jiwon-kang-dev/stm32-can-pedal-dashboard-ecu/README.md

# STM32 CAN Pedal–Dashboard ECU Simulator

A two-node embedded system that reads a simulated accelerator-pedal input, transmits the pedal position over CAN, controls a dashboard LED using PWM, and activates fail-safe behavior when communication is lost.

## Project Overview

This project simulates a basic automotive in-vehicle communication system using two STM32 Nucleo-F446RE boards.

The **Pedal ECU** reads an analog pedal input through ADC, converts the measured value into a pedal percentage from 0% to 100%, and transmits the result periodically over CAN.

The **Dashboard ECU** receives the pedal message, controls the onboard LED brightness through PWM, detects CAN communication timeout, and forces the LED output to zero as a fail-safe action.

When CAN communication is restored, the Dashboard ECU automatically returns to normal operation.

---

## Hardware

- STM32 Nucleo-F446RE x2
- SN65HVD230 CAN Transceiver x2
- 10kΩ Potentiometer
- LED
- 120Ω termination resistor x2
- Breadboard and jumper wires
- Logic Analyzer

---

## Development Environment

- STM32CubeIDE
- STM32CubeMX
- Tera Term
- Windows

---

## Project Highlights

- Two STM32 Nucleo-F446RE boards operating as independent ECUs
- Analog pedal input measured using a 12-bit ADC
- Pedal position converted into a percentage from 0% to 100%
- Standard CAN communication at 500 kbps
- Pedal message transmitted every 100 ms
- Dashboard LED brightness controlled using PWM
- CAN timeout detection after 1 second without a valid message
- Fail-safe LED OFF behavior and automatic recovery
- Non-blocking super-loop structure using `HAL_GetTick()`
- CAN frame and transmission period verified using a logic analyzer

---

## System Architecture

```mermaid
flowchart LR
    POT[10 kΩ Potentiometer] -->|Analog voltage| PEDAL[Pedal ECU<br/>STM32F446RE]
    PEDAL -->|ADC 0–4095| SCALE[Pedal Position<br/>0–100%]
    SCALE -->|CAN ID 0x100<br/>100 ms period| BUS[CAN Bus<br/>500 kbps]
    BUS --> DASH[Dashboard ECU<br/>STM32F446RE]
    DASH -->|Pedal % to PWM duty| LED[Dashboard LD2]
    DASH -->|No valid frame for 1 s| SAFE[Fail-safe<br/>PWM = 0]
```

### ECU Responsibilities

| ECU | Input | Processing | Output |
|---|---|---|---|
| Pedal ECU | Potentiometer through ADC | Converts the 12-bit ADC value into a pedal percentage and transmits it periodically | CAN message `0x100` |
| Dashboard ECU | CAN message `0x100` | Validates the pedal data, calculates PWM duty, and monitors communication timeout | LD2 brightness, UART logs, and fail-safe output |

---

## Implementation Status

- [x] UART debugging using register-level code and STM32 HAL
- [x] Analog pedal input measurement using ADC
- [x] Pedal percentage conversion from 0% to 100%
- [x] Dashboard LED brightness control using PWM
- [x] CAN transmission and reception between two ECUs
- [x] CAN timeout detection and fail-safe LED OFF behavior
- [x] Automatic recovery after CAN communication is restored
- [x] Non-blocking periodic processing using `HAL_GetTick()`
- [x] CAN waveform, transmission period, and frame verified using a logic analyzer
- [x] Final integrated system demo

---

## CAN Message Specification

The Pedal ECU reads the potentiometer value through ADC, converts it into a pedal position from 0% to 100%, and transmits the result to the Dashboard ECU through CAN.

| Field | Specification |
|---|---|
| CAN frame type | Standard 11-bit identifier |
| CAN ID | `0x100` |
| Bitrate | 500 kbps |
| DLC | 1 byte |
| `Data[0]` | Pedal position from `0` to `100` |
| Transmission period | 100 ms |
| CAN TX pin | PB9 |
| CAN RX pin | PB8 |
| Timeout threshold | 1000 ms |

### Payload Example

```text
Data[0] = 0x43
0x43 = 67 decimal
Pedal position = 67%
```

The Dashboard ECU receives CAN message `0x100`, checks whether the pedal value is within the valid range of 0 to 100, and converts the received value into PWM duty.

The onboard LED brightness changes according to the received pedal position.

If no valid pedal message is received for more than 1000 ms, the Dashboard ECU activates the fail-safe state and forces the PWM duty to zero.

When a valid CAN message is received again, the fail-safe state is cleared and normal PWM control resumes.

---

## Verification Results

| Test Item | Result |
|---|---|
| ADC pedal input | Potentiometer value successfully converted into a pedal position from 0% to 100% |
| CAN transmission | Pedal ECU periodically transmitted CAN message `0x100` |
| CAN reception | Dashboard ECU successfully received and validated the pedal data |
| PWM control | Dashboard LD2 brightness changed according to the received pedal position |
| Timeout detection | Communication loss detected after approximately 1000 ms |
| Fail-safe behavior | PWM duty forced to zero and Dashboard LD2 turned off |
| Communication recovery | Normal PWM control resumed after receiving a valid CAN message |
| Transmission period | Logic analyzer measurement confirmed approximately 100 ms |
| CAN frame decoding | CAN ID `0x100`, DLC `1`, and pedal payload successfully decoded |
| TXD/RXD comparison | Matching CAN frame patterns observed between transmitter TXD and receiver RXD |

---

## Demo and Evidence

### Final Integrated System Demo

The Pedal ECU reads the potentiometer input, converts it into a pedal percentage, and transmits the value to the Dashboard ECU through CAN.

The Dashboard ECU controls the onboard LED brightness according to the received pedal position. The demo also shows communication timeout detection, fail-safe LED OFF behavior, and automatic recovery after CAN communication is restored.

[Watch the final integrated system demo](images/07_timeout_failsafe_demo.mp4.mp4)

#### Fail-safe Evidence

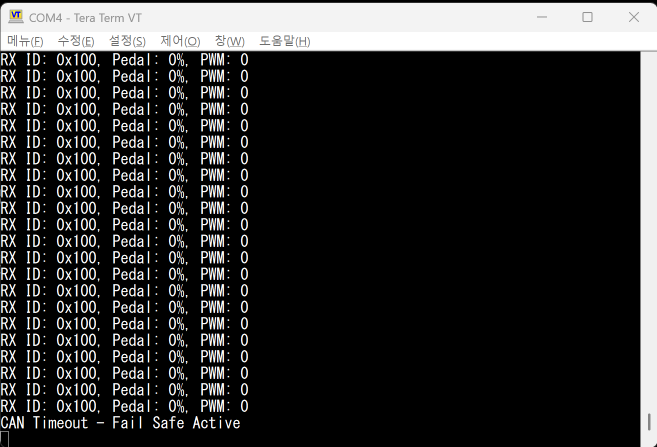
[picture p1: images/07_timeout_failsafe_output.png.png]
CAN Timeout Fail-safe Output


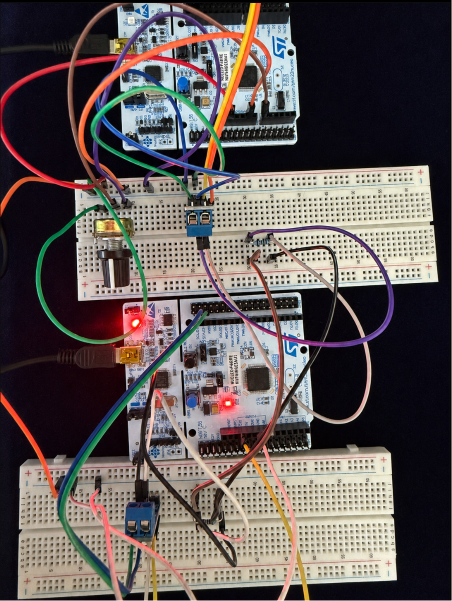
[picture p2: images/07_failsafe_led_off.png]
Fail-safe LED OFF


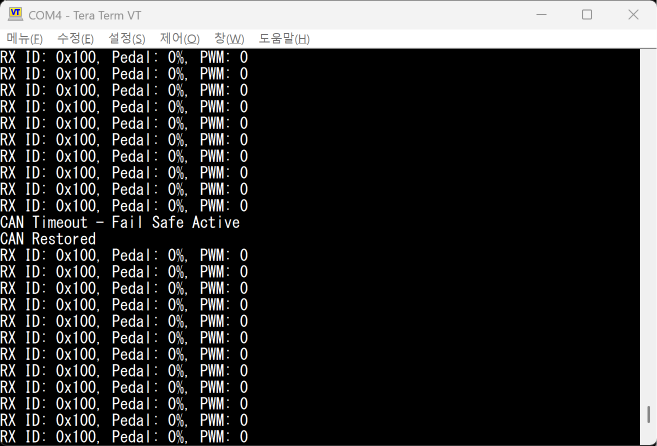
[picture p3: images/07_can_restored_output.png]
CAN Restored Output


### Logic Analyzer Verification

The physical CAN signals were measured at the Pedal ECU transmitter TXD and Dashboard ECU receiver RXD.

#### TXD and RXD Comparison

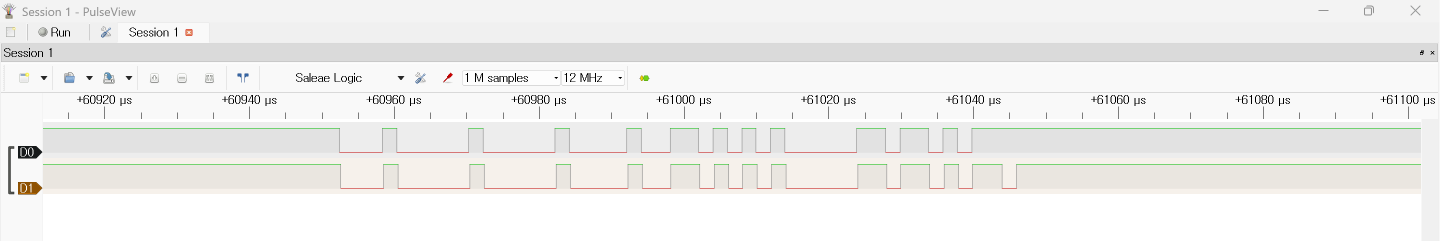
[picture p4: images/10_logic_analyzer_tx_rx_comparison.png]
CAN TXD and RXD Comparison


#### Transmission Period

The measured interval between consecutive CAN frames was approximately 100 ms.

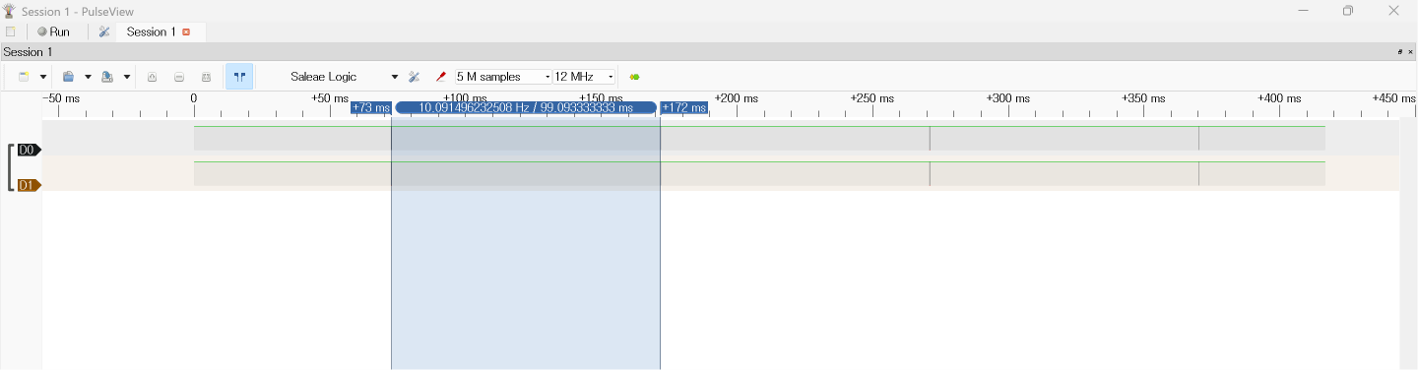
[picture p5: images/10_logic_analyzer_can_period.png]
CAN Transmission Period


#### CAN Frame Decode

The logic analyzer decoded CAN ID `0x100`, DLC `1`, and the pedal-position payload.

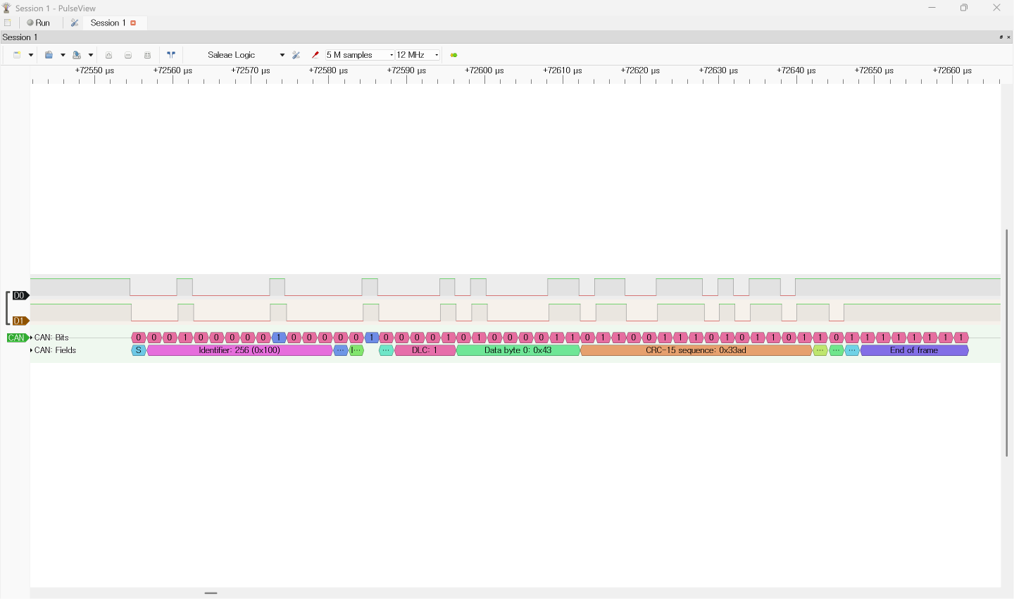
[picture p6: images/10_logic_analyzer_can_decode.png]
CAN Frame Decode


<details>
<summary><strong>Additional Development Evidence</strong></summary>

### ADC Pedal Input

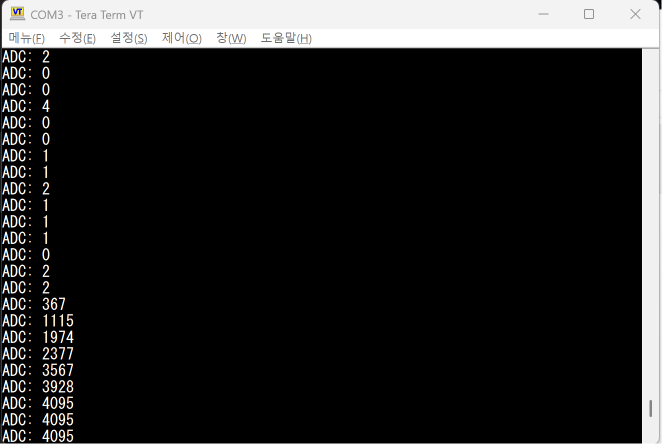
[picture p7: images/adc_teraterm_output.png]
ADC Output


### CAN Transmission and Reception

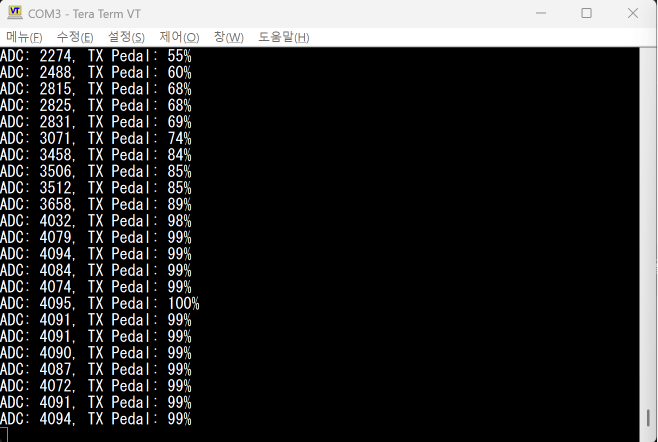
[picture p8: images/05_can_tx_teraterm_output.png.png]
CAN TX Tera Term Output


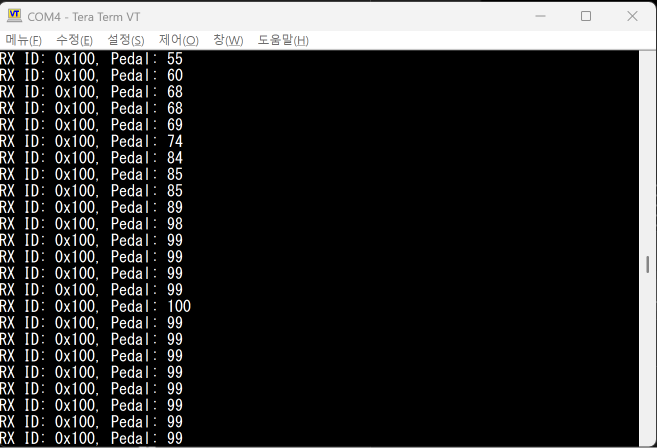
[picture p9: images/05_can_rx_teraterm_output.png.png]
CAN RX Tera Term Output


### CAN Bus Wiring

CAN Wiring Top View


CAN Wiring Side View


### Dashboard PWM Control

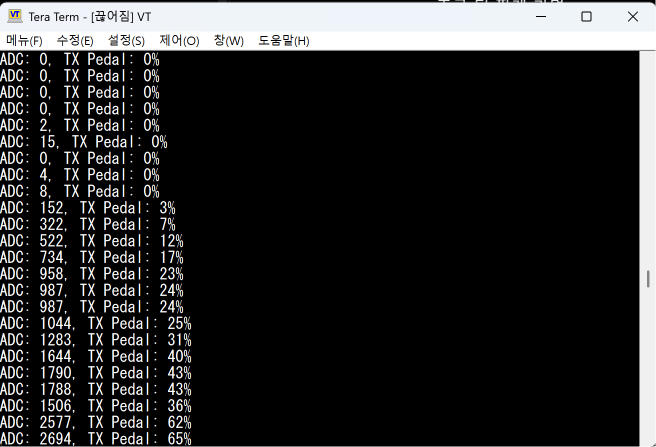
[picture p12: images/06_can_tx_pedal_pwm_output.png]
CAN TX Pedal PWM Output


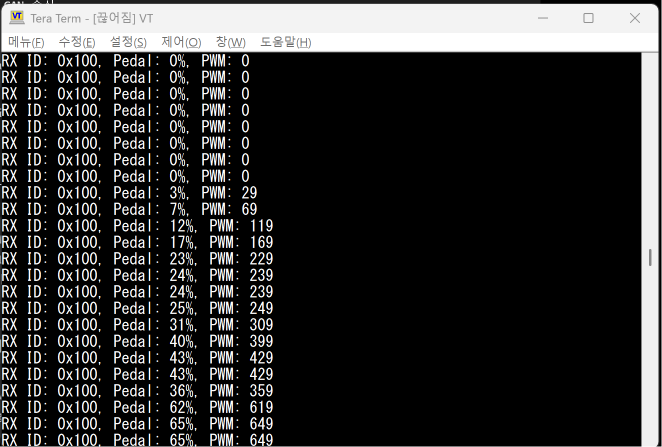
[picture p13: images/06_dashboard_pwm_output.png]
Dashboard PWM Output


Dashboard LED Brightness Low


Dashboard LED Brightness High


</details>

---

## Development Notes

- [UART Register Test](notes/01_uart_register_test.md)
- [UART ADC HAL Test](notes/02_uart_adc_hal_test.md)
- [ADC to Pedal Percent](notes/03_adc_to_pedal_percent.md)
- [PWM LED Control](notes/04_pwm_led_control.md)
- [CAN Pedal Value Transmission Test](notes/05_can_pedal_value_transmission.md)
- [Dashboard PWM Control Using Received CAN Data](notes/06_dashboard_pwm_control.md)
- [CAN Timeout and Fail-safe Test](notes/07_can_timeout_failsafe.md)
- [Non-blocking Pedal ECU CAN Transmission](notes/08_non_blocking_pedal_tx.md)
- [Non-blocking Dashboard ECU Receive and Timeout Loop](notes/09_non_blocking_dashboard_rx.md)
- [CAN Logic Analyzer Verification](notes/10_logic_analyzer_verification.md)

---

## Firmware

- [UART Register Test](firmware/uart_register_test/main.c)

- [Pedal ECU CAN TX Firmware](firmware/pedal_ecu_can_tx/main.c)
- [Pedal ECU CAN TX CubeMX Configuration](firmware/pedal_ecu_can_tx/pedal_ecu_can_tx.ioc)

- [Dashboard ECU CAN RX Firmware](firmware/dashboard_ecu_can_rx/main.c)
- [Dashboard ECU CAN RX CubeMX Configuration](firmware/dashboard_ecu_can_rx/dashboard_ecu_can_rx.ioc)

---

## Technical Challenges and Solutions

| Challenge | Cause | Solution |
|---|---|---|
| CAN messages were not transmitted successfully | CAN TX/RX wires were connected to the wrong header pins | Moved the CAN connections to PB9 TX and PB8 RX on the Morpho connector |
| CAN communication was unstable | Incomplete bus wiring and termination | Connected a common ground and installed 120 Ω termination resistors at both ends of the CAN bus |
| Periodic transmission blocked other processing | The transmit loop used `HAL_Delay()` | Replaced the blocking delay with a `HAL_GetTick()`-based 100 ms scheduler |
| Dashboard output could retain stale pedal data | No communication-loss handling was implemented | Added a 1000 ms timeout and forced PWM duty to zero during the fail-safe state |
| Hardware behavior was difficult to confirm using UART alone | UART logs could not prove the physical CAN timing and frame contents | Measured TXD/RXD signals and decoded CAN ID, DLC, payload, and transmission period using a logic analyzer |
| The logic analyzer was not initially recognized correctly | An incompatible USB driver was installed | Installed the WinUSB driver and configured the FX2-based device in PulseView |

---

## Limitations and Future Improvements

- Replace polling-based CAN reception with interrupt-driven reception
- Add CAN error monitoring and automatic bus-off recovery
- Define additional CAN messages and organize signals using a DBC-style specification
- Add filtering and plausibility checks for the analog pedal input
- Separate peripheral drivers, application logic, and fail-safe state management into independent modules
- Add diagnostic information such as error status and communication state
- Extend the system using an RTOS with periodic tasks and event-based processing
- Implement automotive diagnostic communication such as UDS in a future version

---

## What I Learned

- Configured and integrated STM32 ADC, UART, PWM, and CAN peripherals
- Designed a simple application-layer CAN message for pedal-position data
- Separated system responsibilities between a Pedal ECU and a Dashboard ECU
- Implemented non-blocking periodic processing using `HAL_GetTick()`
- Implemented communication timeout detection, fail-safe output, and automatic recovery
- Understood CAN physical-layer requirements including transceivers, common ground, and termination resistors
- Diagnosed CAN communication problems through wiring checks and UART debugging
- Verified real hardware behavior using logic-analyzer timing measurements and CAN frame decoding
- Organized firmware, configuration files, verification evidence, and development records in GitHub
