jiwon-kang-dev/stm32-can-pedal-dashboard-ecu/images/pwm_led_wiring_demo_high.jpg.jpg

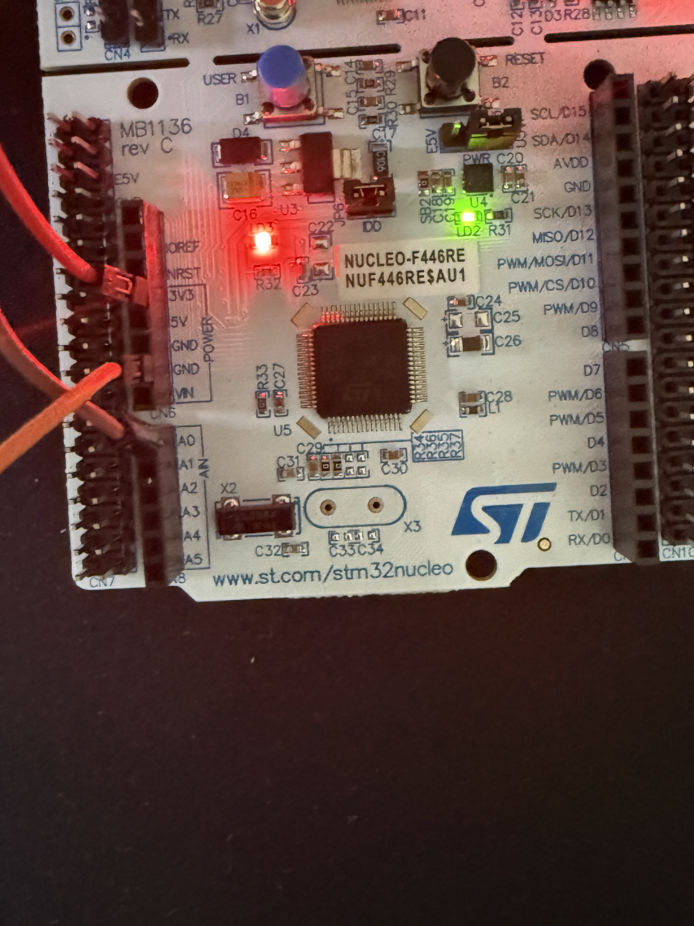
images/pwm_led_wiring_demo_high.jpg.jpg
