jiwon-kang-dev/stm32-can-pedal-dashboard-ecu/firmware/dashboard_ecu_can_rx/main.c

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
/* Includes ------------------------------------------------------------------*/
#include "main.h"

/* USER CODE BEGIN Includes */
#include <stdio.h>
#include <string.h>
/* USER CODE END Includes */

/* USER CODE BEGIN PD */
#define PEDAL_CAN_ID 0x100
#define CAN_TIMEOUT_MS 1000
#define PWM_MAX_DUTY 999
/* USER CODE END PD */



CAN_HandleTypeDef hcan1;

TIM_HandleTypeDef htim2;

UART_HandleTypeDef huart2;

/* USER CODE BEGIN PV */
CAN_RxHeaderTypeDef RxHeader;
uint8_t RxData[8];
char msg[100];

uint32_t lastRxTime = 0;
uint8_t timeoutFlag = 0;
/* USER CODE END PV */

void SystemClock_Config(void);
static void MX_GPIO_Init(void);
static void MX_CAN1_Init(void);
static void MX_USART2_UART_Init(void);
static void MX_TIM2_Init(void);
/**
  * @brief  The application entry point.
  * @retval int
  */
int main(void)
{

  /* MCU Configuration--------------------------------------------------------*/

  /* Reset of all peripherals, Initializes the Flash interface and the Systick. */
  HAL_Init();

  /* Configure the system clock */
  SystemClock_Config();

  /* Initialize all configured peripherals */
  MX_GPIO_Init();
  MX_CAN1_Init();
  MX_USART2_UART_Init();
  MX_TIM2_Init();
  /* USER CODE BEGIN 2 */
  CAN_FilterTypeDef canfilterconfig;

  canfilterconfig.FilterActivation = CAN_FILTER_ENABLE;
  canfilterconfig.FilterBank = 0;
  canfilterconfig.FilterFIFOAssignment = CAN_RX_FIFO0;
  canfilterconfig.FilterIdHigh = 0x0000;
  canfilterconfig.FilterIdLow = 0x0000;
  canfilterconfig.FilterMaskIdHigh = 0x0000;
  canfilterconfig.FilterMaskIdLow = 0x0000;
  canfilterconfig.FilterMode = CAN_FILTERMODE_IDMASK;
  canfilterconfig.FilterScale = CAN_FILTERSCALE_32BIT;
  canfilterconfig.SlaveStartFilterBank = 14;

  HAL_CAN_ConfigFilter(&hcan1, &canfilterconfig);
  HAL_CAN_Start(&hcan1);

  HAL_TIM_PWM_Start(&htim2, TIM_CHANNEL_1);

  snprintf(msg, sizeof(msg), "Dashboard ECU CAN RX PWM Start\r\n");
  HAL_UART_Transmit(&huart2, (uint8_t*)msg, strlen(msg), 100);

  lastRxTime = HAL_GetTick();
  /* USER CODE END 2 */

  /* Initialize leds */
  //BSP_LED_Init(LED2);

  /* Initialize USER push-button, will be used to trigger an interrupt each time it's pressed.*/
  BSP_PB_Init(BUTTON_USER, BUTTON_MODE_EXTI);

  /* Infinite loop */
  /* USER CODE BEGIN WHILE */
  while (1)
  {
    /* USER CODE END WHILE */

    /* USER CODE BEGIN 3 */

	  uint32_t currentTime = HAL_GetTick();

	  /* Check received CAN message */
	  if (HAL_CAN_GetRxFifoFillLevel(&hcan1, CAN_RX_FIFO0) > 0)
	  {
	    HAL_CAN_GetRxMessage(&hcan1, CAN_RX_FIFO0, &RxHeader, RxData);

	    if (RxHeader.StdId == PEDAL_CAN_ID && RxHeader.DLC >= 1)
	    {
	      uint8_t pedal_percent = RxData[0];
	      uint32_t pwm_duty = 0;

	      /* Update last CAN receive time */
	      lastRxTime = currentTime;

	      /* If CAN was in timeout state, restore normal state */
	      if (timeoutFlag == 1)
	      {
	        timeoutFlag = 0;

	        snprintf(msg, sizeof(msg), "CAN Restored\r\n");
	        HAL_UART_Transmit(&huart2, (uint8_t*)msg, strlen(msg), 100);
	      }

	      /* Limit pedal value */
	      if (pedal_percent > 100)
	      {
	        pedal_percent = 100;
	      }

	      /* Convert pedal percentage to PWM duty */
	      pwm_duty = (pedal_percent * PWM_MAX_DUTY) / 100;

	      /* Update Dashboard LED brightness */
	      __HAL_TIM_SET_COMPARE(&htim2, TIM_CHANNEL_1, pwm_duty);

	      snprintf(msg, sizeof(msg), "RX ID: 0x%03lX, Pedal: %d%%, PWM: %lu\r\n",
	               (unsigned long)RxHeader.StdId,
	               pedal_percent,
	               (unsigned long)pwm_duty);

	      HAL_UART_Transmit(&huart2, (uint8_t*)msg, strlen(msg), 100);
	    }
	  }

	  /* CAN timeout check */
	  if ((currentTime - lastRxTime) > CAN_TIMEOUT_MS)
	  {
	    if (timeoutFlag == 0)
	    {
	      timeoutFlag = 1;

	      /* Fail-safe: turn off Dashboard LED */
	      __HAL_TIM_SET_COMPARE(&htim2, TIM_CHANNEL_1, 0);

	      snprintf(msg, sizeof(msg), "CAN Timeout - Fail Safe Active\r\n");
	      HAL_UART_Transmit(&huart2, (uint8_t*)msg, strlen(msg), 100);
	    }
	  }

  /* USER CODE END 3 */
}
}

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
