jiwon-kang-dev/stm32-can-pedal-dashboard-ecu/(commit log)

2026-07-10 Add UART register test code
2026-07-10 Document UART register test
2026-07-11 Document HAL UART and ADC test
2026-07-11 Update progress after ADC test
2026-07-11 Add ADC test images
2026-07-11 Add ADC test evidence images
2026-07-11 Add ADC demo image to README
2026-07-11 Add ADC pedal percentage output image
2026-07-11 Document ADC to pedal percentage conversion
2026-07-12 Add PWM LED control output image
2026-07-12 Document PWM LED control test
2026-07-12 Update progress after PWM LED control
2026-07-14 Add dashboard PWM control images
2026-07-14 Add dashboard PWM control test note
2026-07-14 Update README with dashboard PWM progress
2026-07-14 Update dashboard ECU firmware with PWM control
2026-07-14 Update dashboard ECU CubeMX configuration for PWM
2026-07-14 Fix dashboard LED brightness image paths
2026-07-14 Update dashboard ECU firmware with timeout fail-safe
    [main.c]
2026-07-16 Replace fail-safe LED OFF image
