jiwon-kang-dev/stm32-can-pedal-dashboard-ecu/(notices)

Notices in the files:
firmware/dashboard_ecu_can_rx/main.c:
Copyright (c) 2026 STMicroelectronics.
All rights reserved.
This software is licensed under terms that can be found in the LICENSE file
