jiwon-kang-dev/stm32-can-pedal-dashboard-ecu/images/05_can_wiring_top_view.jpg.jpg

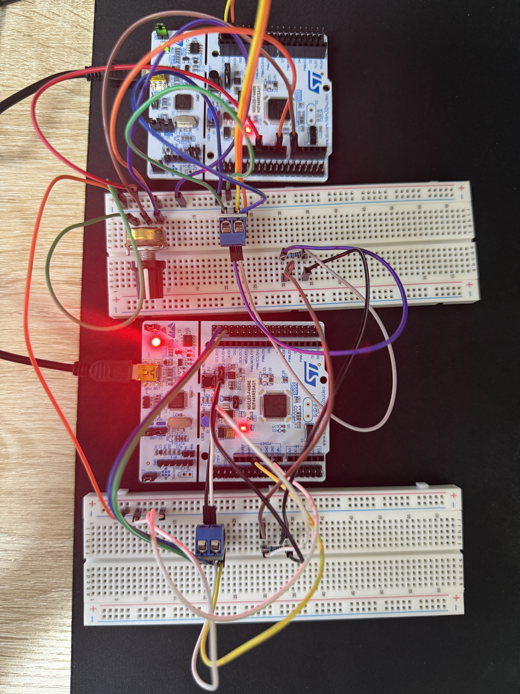
[picture p10: images/05_can_wiring_top_view.jpg.jpg]
images/05_can_wiring_top_view.jpg.jpg
