jiwon-kang-dev/stm32-can-pedal-dashboard-ecu/images/05_can_wiring_side_view.jpg.jpg

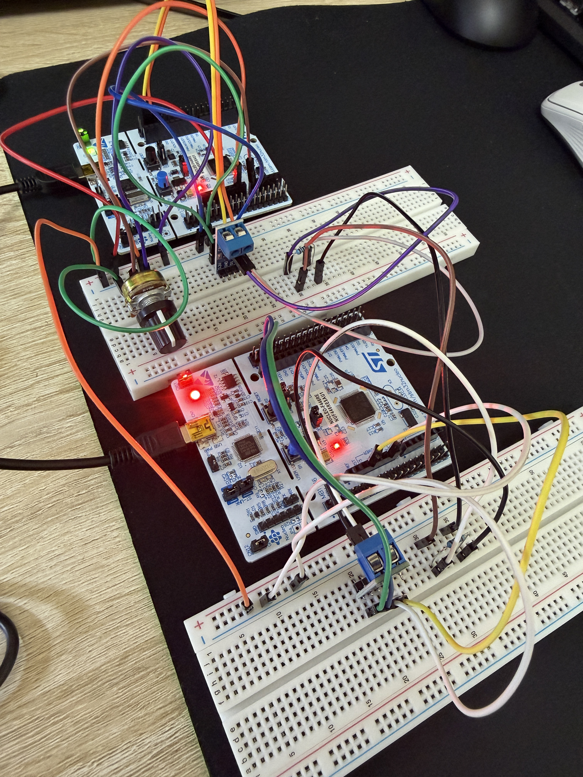
[picture p11: images/05_can_wiring_side_view.jpg.jpg]
images/05_can_wiring_side_view.jpg.jpg
