jiwon-kang-dev/stm32-can-pedal-dashboard-ecu/images/06_dashboard_led_brightness_low.jpg.jpg

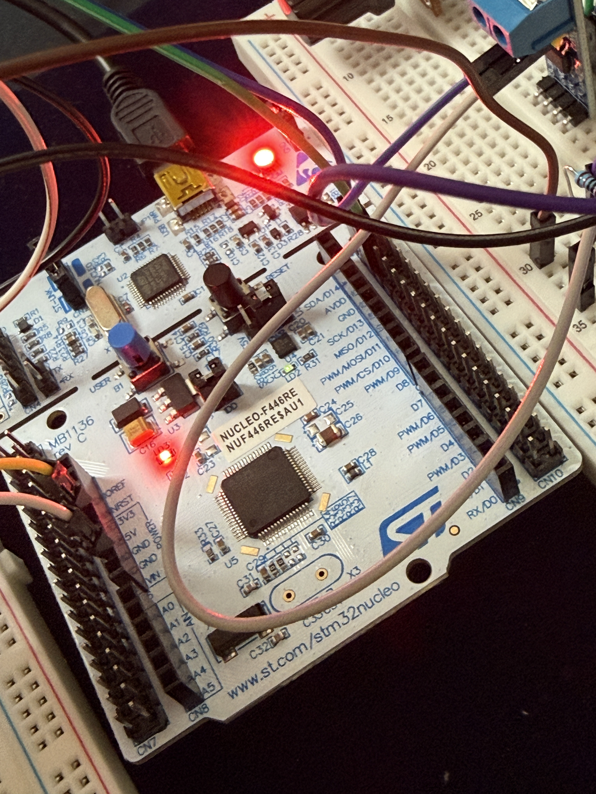
[picture p14: images/06_dashboard_led_brightness_low.jpg.jpg]
images/06_dashboard_led_brightness_low.jpg.jpg
