jiwon-kang-dev/stm32-can-pedal-dashboard-ecu/images/06_dashboard_led_brightness_high.jpg.jpg

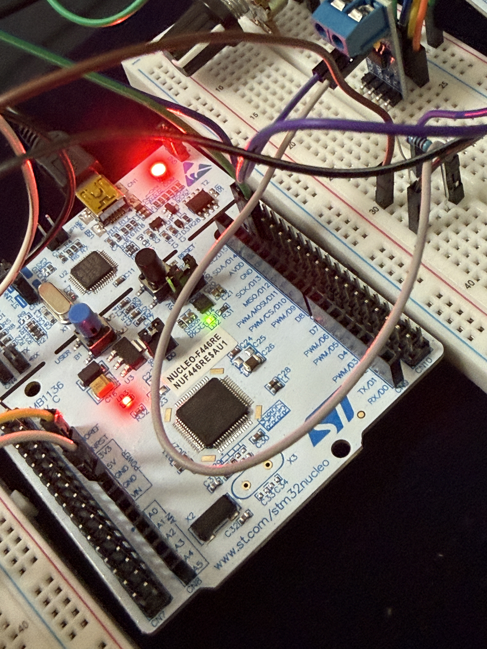
[picture p15: images/06_dashboard_led_brightness_high.jpg.jpg]
images/06_dashboard_led_brightness_high.jpg.jpg
