jiwon-kang-dev/stm32-can-pedal-dashboard-ecu/images/adc_potentiometer_wiring.jpg

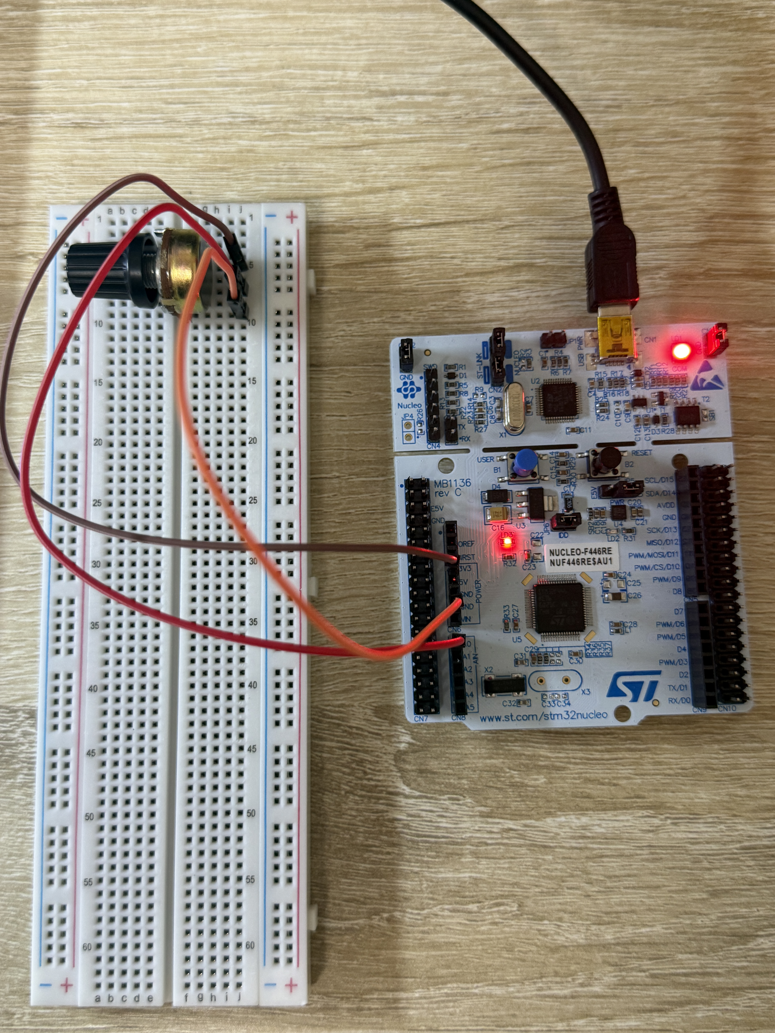
[picture p20: images/adc_potentiometer_wiring.jpg]
images/adc_potentiometer_wiring.jpg
